633k4hire/CncLatheXZA/3.Documentation/0.Wiring/dlc32 wiring example.jpeg

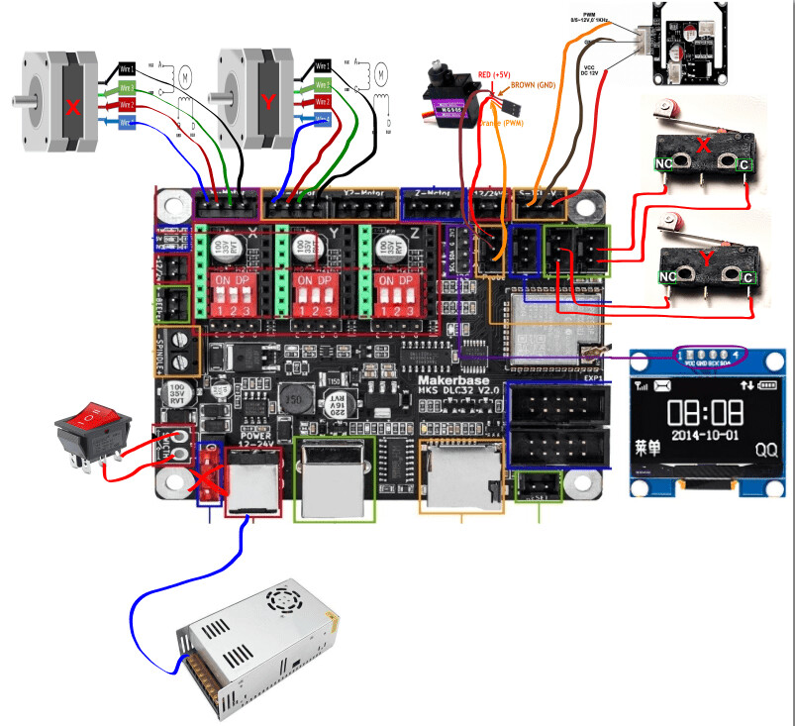
3.Documentation/0.Wiring/dlc32 wiring example.jpeg
