633k4hire/CncLatheXZA/README.md

# CncLatheXZA

Micro-manufacturing CNC lathe for batch machining.

This repository holds the physical machine artifacts for the XZA lathe: CAD,
wiring notes, FluidNC configuration, commissioning records, BOM material, and
generated G-code outputs. Reusable firmware work lives in the sibling firmware
repositories in the `XZA-Lathe` super-repo.

## Current FluidNC Config

The active machine configuration is in
[`2.Software/FluidNC/current-config`](2.Software/FluidNC/current-config):

- [`maijker_xzact_mini_lathe.yaml`](2.Software/FluidNC/current-config/maijker_xzact_mini_lathe.yaml)
  - MKS-DLC32 V2.1 FluidNC config for the current XZACt mini lathe build, using
    the first-class `maijker_5_station_turret` ATC driver.
- [`lathe-v3-config-audit.md`](2.Software/FluidNC/current-config/lathe-v3-config-audit.md)
  - audit of the checked-in config and the physical validation items that remain
    open before cutting.

The old SD-card turret macro is preserved only as a legacy reference at
[`3.Documentation/legacy/maijker_tool_change_legacy.gcode`](3.Documentation/legacy/maijker_tool_change_legacy.gcode).

## Commissioning

Use the staged
[`Lathe V3 Commissioning Checklist`](3.Documentation/commissioning/lathe-v3-commissioning-checklist.md)
before putting the machine under real cutting load.

Threading is intentionally disabled until a physical spindle encoder is
installed and low-speed feedback is verified through FluidNC `ESP421`.

## Reference Images

XZA lathe
Lathe v2
