633k4hire/CncLatheXZA/3.Documentation/2.Hardware Documentation/nema 23 torque curve.pdf

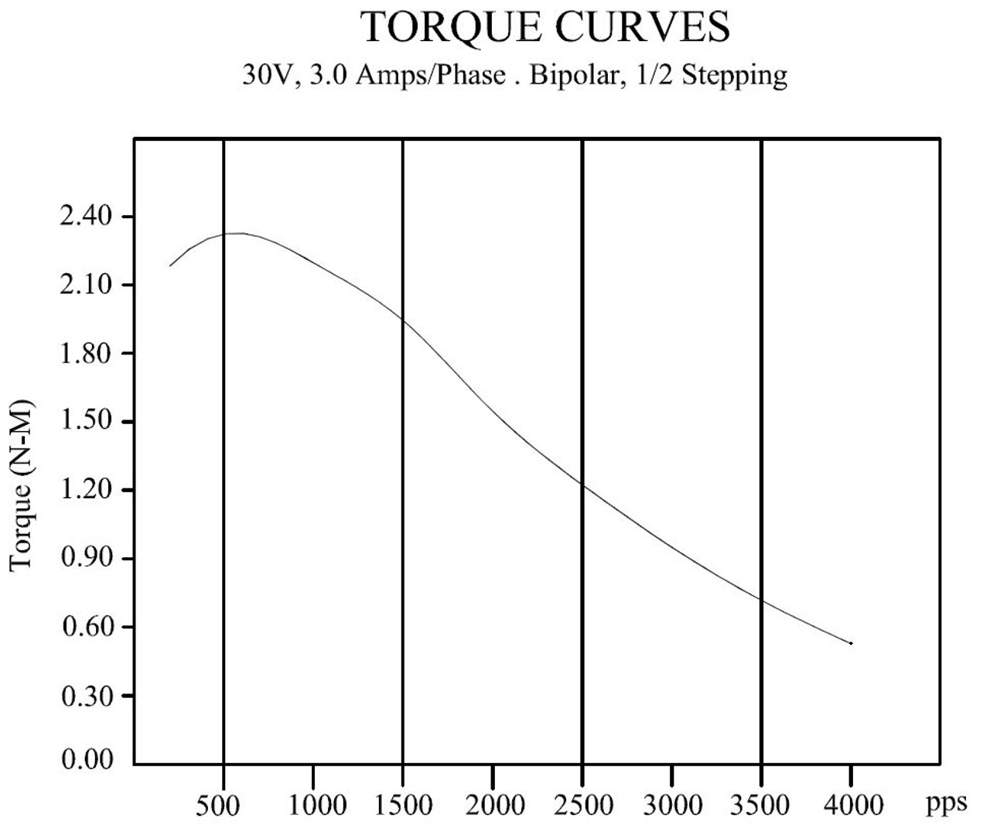
[picture p2: page 1]
