633k4hire/CncLatheXZA/4.BOM/Lathe V6 BOM - AliExpress Spindle.xlsx

Lathe V6 - BOM
Item | Vendor | QTY | COST | TOTAL
2Kit GT2 Pulley 20&60 Teeth 6.35mm Bore, Aluminum Timing Pulley with 2PCS Timing Belt 200mm Length 6mm | Amazon | 1 | $11.85 | 491.62
13Inch Square Aluminum 12mm Flat BAR 3 Pieces 6061 General Purpose Plate,T6511 Solid New Mill Stock | Amazon | 1 | $16.16
24 Volt 6 Amp Power Supply Adapter | Amazon | 1 | $18.32
150 Pieces 2020 Series T Nuts T-Slot Nut Hammer Head Fastener -Plated Carbon Steel Sliding T Nuts for Aluminum Profile (M5) | Amazon | 1 | $7.92
Aluminum Extrusion - MISUMI | MISUMI | 1 | $47.96
Befenybay 100mm Length Travel Linear Stage Actuator with Square Linear Rails Ballscrew SFU1605 with NEMA17 | Amazon | 1 | $79.56
Befenybay 150mm Length Travel Linear Stage Actuator with Square Linear Rails Ballscrew SFU1605 with NEMA17 Stepper Motor | Amazon | 1 | $84.95
EASON Stepper Motor Driver TB6600 | Amazon | 1 | $10.66
Genmitsu 6PCS Micro Limit Switches with 1M 3 Pin Cable | Amazon | 1 | $12.93
Genmitsu CNC Router Emergency Stop Switch Push Button | Amazon | 1 | $10.77
LHGS16-20 linear bearing housing - MISUMI | MISUMI | 1 | $0.00
Makerbase MKS DLC32 | Amazon | 1 | $66.02
PZRT 2 Sets Thrust Needle Roller Bearings AXK1226 Thrust Needle Roller Bearing with Washers | Amazon | 1 | $0.00
RATTMMOTOR K02-50mm Mini Lathe Chuck 4 Jaw Self-Centering Chuck M14 | Amazon | 1 | $52.93
Spindle Assembly Mini Lathe - ALIEXPRESS | ALIEXPRESS | 1 | $33.88
Stainless Steel Chuck Connecting Rod for K01-50 Lathe Chuck, M14x1 Mini Lathe Machine Parts(6mm) | Amazon | 1 | $0.00
TMYPN 5Pcs GT2 Pulley 20 Teeth 8mm Bore for 3D Printer Parts CNC Machine 6mm Width 20T Timing Belt, | Amazon | 1 | $8.61
urkit Metric M14 X 1 Round Threading Die, M14 x 1.0 Machine Thread Die Right Hand | Amazon | 1 | $0.00
Utoolmart Round Steel Rod, 12mm HSS Lathe Bar Stock Tool 100mm Long | Amazon | 1 | $0.00
uxcell 6001ZZ Deep Groove Ball Bearing 12x28x8mm Double Shielded ABEC-3 Bearings 2-Pack | Amazon | 1 | $0.00
VerLich Lathe Turning Tools,S12M SCLCR09 SCLCR1212H09 SCLCL1212H09 SCMCN1212H09 Boring Bar Turning Tool Holder With 10pcs CCMT09T304 Inserts | Amazon | 1 | $29.10
