633k4hire/CncLatheXZA/5.Gcode Output/Setup Sheet for Program 1001.pdf

# Setup Sheet for Program 1001

Job Description: Setup2

# Document Path: MakeSense Case - Job Setup v5

# Setup

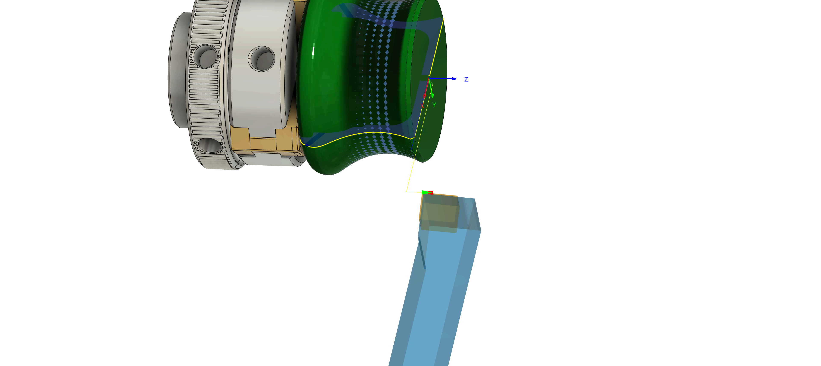
[picture p3: figure]

# WCS: #0

Stock:

# DX: 51.99mm DY: 51.99mm DZ: 30.36mm

Part:

# DX: 51.99mm DY: 51.99mm DZ: 30.06mm

Stock Lower in WCS #0:

# X: -26mm Y: -26mm Z: -30.06mm

Stock Upper in WCS #0:

# X: 26mm Y: 26mm Z: 0.3mm

# Total

Number Of Operations: 1

Number Of Tools: 1

Tools: T1

Maximum Z: 5.6mm

Minimum Z: 0mm

Maximum Feedrate: 60mm/min

Maximum Spindle Speed: 5000rpm

Cutting Distance: 32.98mm

Rapid Distance: 57.35mm

Estimated Cycle Time: 49s

# Tools

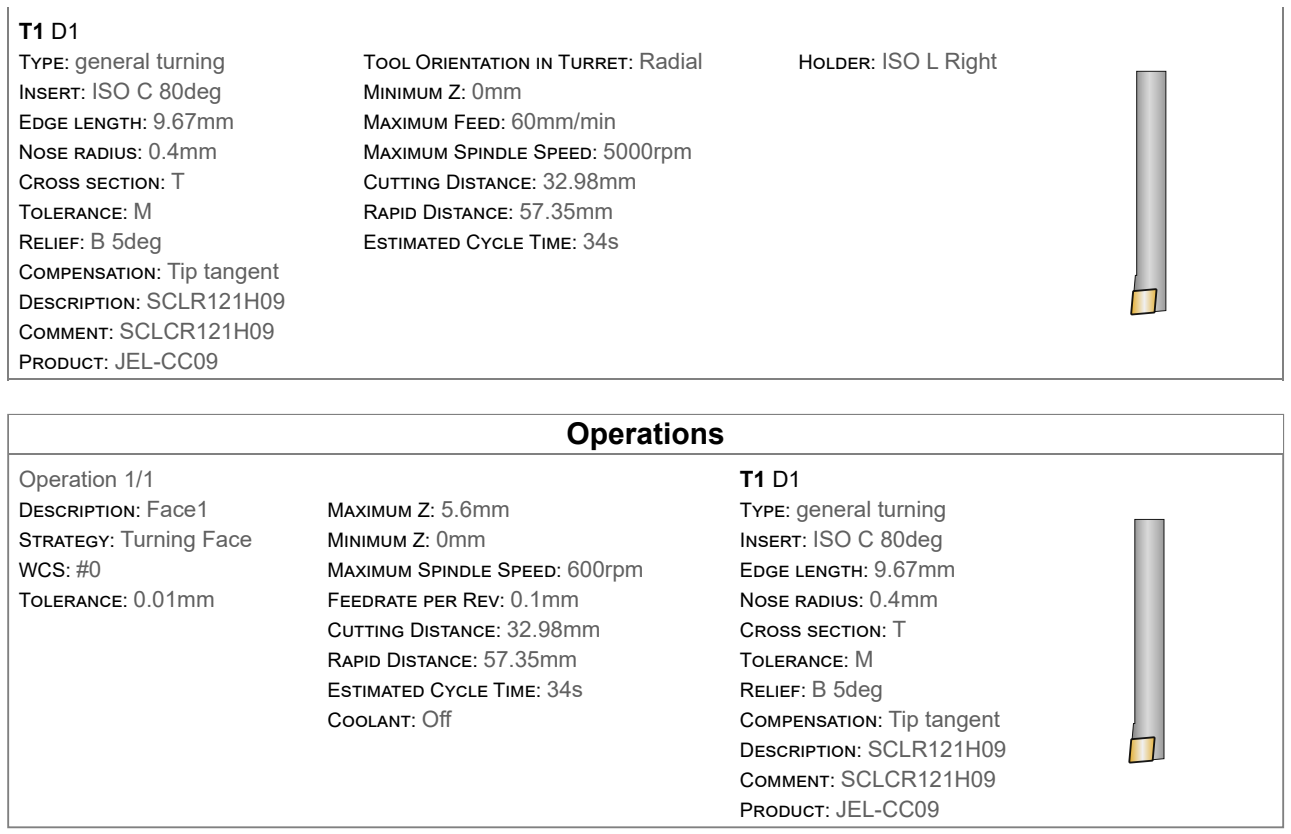
[picture p4: figure]
T1 D1 Type: general turning Insert: ISO C 80deg; Edge length: 9.67mm; Nose radius: 0.4mm; Cross section: T; Tolerance: M; Relief: B 5deg; Compensation: Tip tangent; Description: SCLR121H09 Comment: SCLCR121H09 Product: JEL-CC09; Tool Orientation in Turret: Radial; Minimum Z: 0mm; Maximum Feed: 60mm/min; Maximum Spindle Speed: 5000rpm; Cutting Distance: 32.98mm; Rapid Distance: 57.35mm; Estimated Cycle Time: 34s; Holder: ISO L Right; Operations; Operation 1/1; Description: Face1 Strategy: Turning Face WCS: #0; Tolerance: 0.01mm; Maximum Z: 5.6mm; Maximum Spindle Speed: 600rpm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

Generated by Fusion CAM 2.0.18950 (http://cam.autodesk.com/) Monday, April 15, 2024 13:59:10
