633k4hire/CncLatheXZA/3.Documentation/2.Hardware Documentation/Nema 23 Wiring.pdf

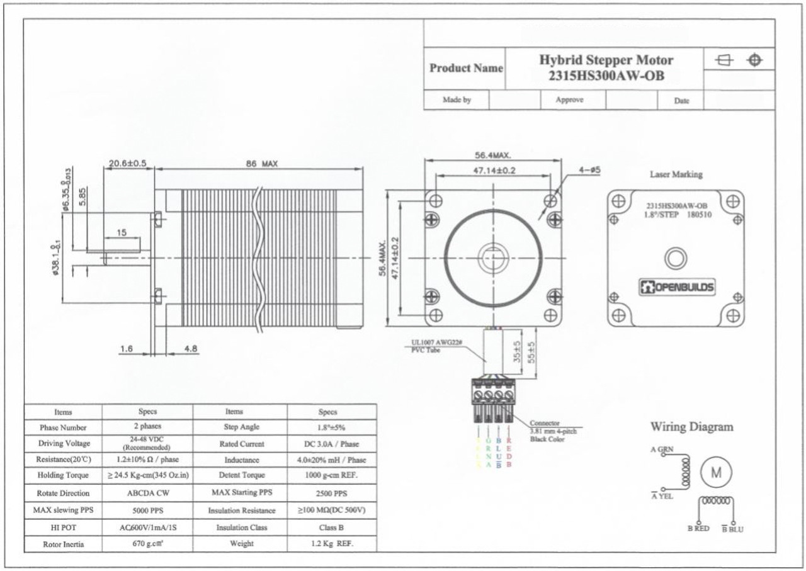
[picture p10: page 1]
