633k4hire/CncLatheXZA/(commit log)

2026-06-18 Add current FluidNC lathe config
    [maijker_xzact_mini_lathe.yaml]
2026-06-18 Use first-class Maijker turret ATC config
    [maijker_xzact_mini_lathe.yaml]
2026-07-27 Configure XZACT shared chuck and adapter contract
    [maijker_xzact_mini_lathe_encoder_bench.yaml]
2026-07-27 Correct Maijker lathe deployment semantics
    [maijker_xzact_mini_lathe.yaml, maijker_xzact_mini_lathe_encoder_bench.yaml]
2026-07-29 Tune jeweler lathe commissioning profile
    [maijker_xzact_mini_lathe.yaml, maijker_xzact_mini_lathe_encoder_bench.yaml]
2026-08-03 Document calibrated direct-drive motion
    [maijker_xzact_mini_lathe.yaml, maijker_xzact_mini_lathe_encoder_bench.yaml]
2026-08-05 config: deploy shared C-stepper spindle profile
    [maijker_xzact_mini_lathe.yaml, maijker_xzact_mini_lathe_encoder_bench.yaml]
2026-08-06 config: increase lathe I2S FIFO margin
    [maijker_xzact_mini_lathe.yaml, maijker_xzact_mini_lathe_encoder_bench.yaml]
2026-08-07 Set machine C drive to smooth 1/8-step profile
    [maijker_xzact_mini_lathe.yaml, maijker_xzact_mini_lathe_encoder_bench.yaml]
2026-08-07 Set machine spindle maximum to 675 RPM
    [maijker_xzact_mini_lathe.yaml, maijker_xzact_mini_lathe_encoder_bench.yaml]
2026-08-11 Align CSS ceiling with 675 RPM spindle
    [maijker_xzact_mini_lathe.yaml, maijker_xzact_mini_lathe_encoder_bench.yaml]
2026-08-14 Document AS5047P encoder commissioning profile
    [maijker_xzact_mini_lathe.yaml]
2026-08-14 Record encoder and OnLogic link commissioning gates
2026-08-15 Classify XZ home switches as positive limits
    [maijker_xzact_mini_lathe.yaml, maijker_xzact_mini_lathe_encoder_bench.yaml]
2026-08-16 Document non-blocking spindle index commissioning
    [maijker_xzact_mini_lathe.yaml]
2026-08-17 Document proven GPIO4 spindle index wiring
    [maijker_xzact_mini_lathe.yaml, maijker_xzact_mini_lathe_encoder_bench.yaml]
2026-08-18 Document C axis 1/16 microstepping
    [maijker_xzact_mini_lathe.yaml, maijker_xzact_mini_lathe_encoder_bench.yaml]
2026-08-18 Document commissioned C driver at eighth step
    [maijker_xzact_mini_lathe.yaml, maijker_xzact_mini_lathe_encoder_bench.yaml]
2026-08-19 Raise lathe DRO report rate
    [maijker_xzact_mini_lathe.yaml, maijker_xzact_mini_lathe_encoder_bench.yaml]
2026-08-20 Add Phase 5 dry threading profile
    [maijker_xzact_mini_lathe_phase5_g33_dry.yaml]
